realworldpixel/home-assistant-keypad/pcb/keypad.kicad_pcb

## KiCad design pcb/keypad.kicad_pcb (2026-10-27)

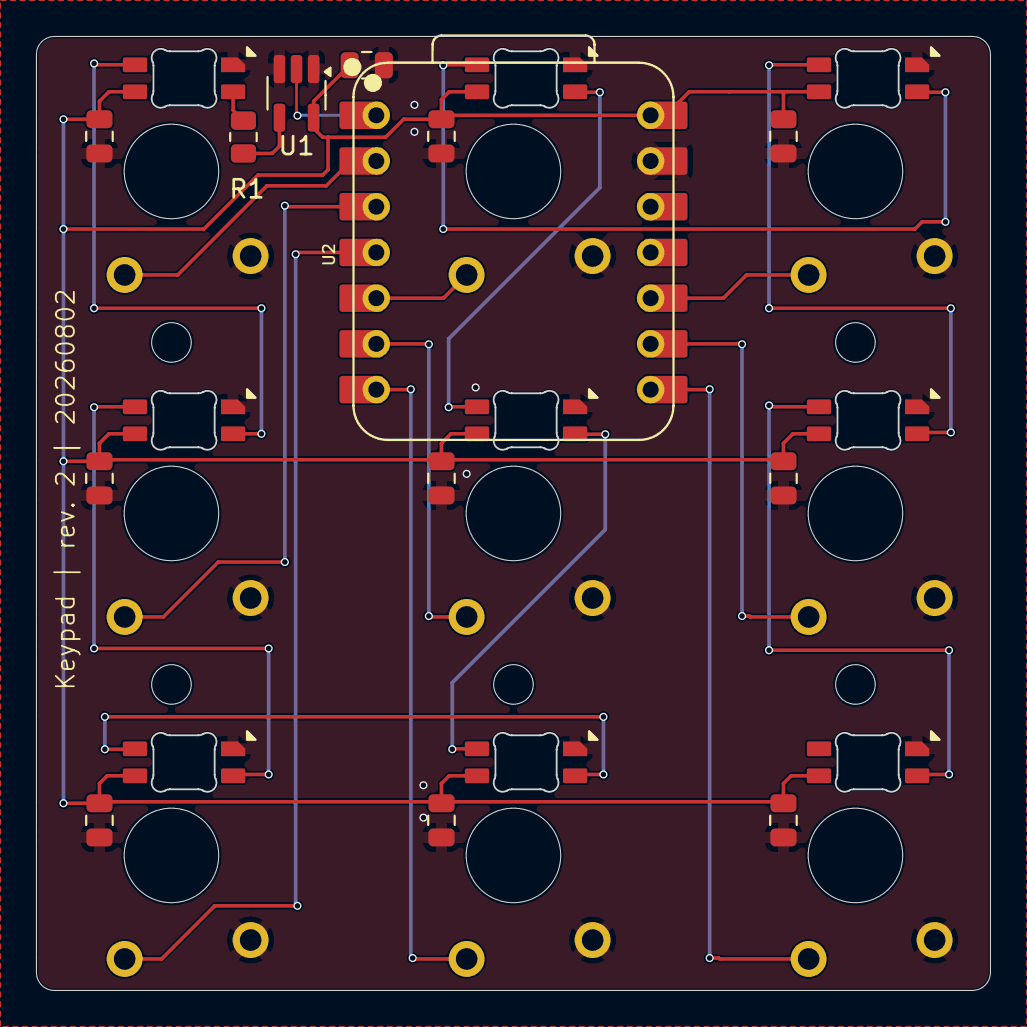
[picture p1: board keypad.kicad_pcb from above]

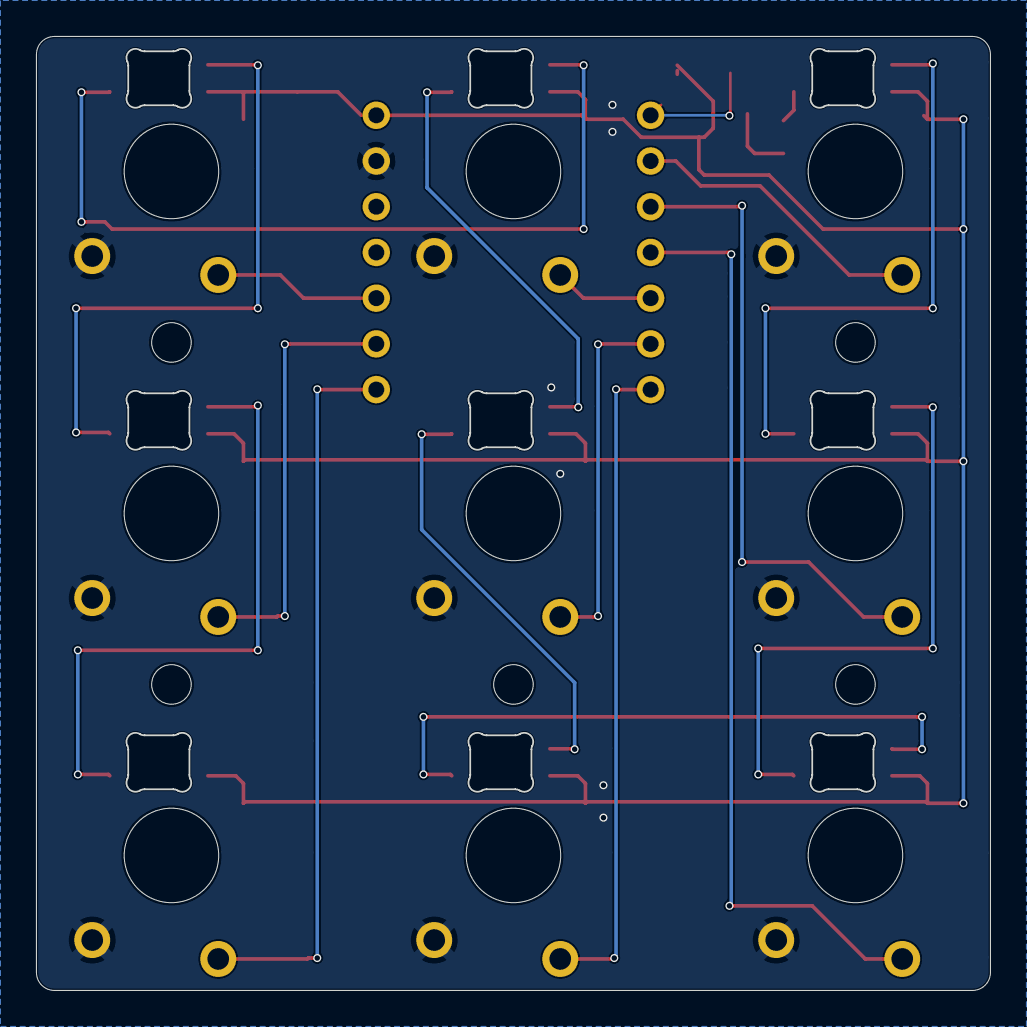
[picture p2: board keypad.kicad_pcb from below]

Board: 2 copper layers, 53.0 x 53.0 mm, 31 parts (9 on the bottom side), 22 nets.

Parts:
C1, C2, C3, C4, C5, C6, C7, C8, C9, C10: C; C_0805_2012Metric
LED1, LED2, LED3, LED4, LED5, LED6, LED7, LED8, LED9: KS33_SK6812MINI-E; LED_KS33_6028R
R1: 220; R_0805_2012Metric
SW1, SW2, SW3, SW4, SW5, SW6, SW7, SW8, SW9: KS33_SW_solder; SW_KS33_1u
U1: 74AHCT1G125; SOT-23-5_HandSoldering
U2: XIAO-ESP32-C6-DIP

Connections:
+5V: C1.1, C2.1, C3.1, C4.1, C5.1, C6.1, C7.1, C8.1, C9.1, C10.1, LED1.1 (VDD), LED2.1 (VDD), LED3.1 (VDD), LED4.1 (VDD), LED5.1 (VDD), LED6.1 (VDD), LED7.1 (VDD), LED8.1 (VDD), LED9.1 (VDD), U1.5, U2.14 (VBUS)
/LED_D3.3: U1.2, U2.1 (GPIO0_A0_D0)
/LED_D5.0: R1.1, U1.4
/SW1: SW1.2, U2.2 (GPIO1_A1_D1)
/SW2: SW2.2, U2.3 (GPIO2_A2_D2)
/SW3: SW3.2, U2.4 (GPIO21_D3)
/SW4: SW4.2, U2.5 (GPIO22_D4_SDA)
/SW5: SW5.2, U2.6 (GPIO23_D5_SCL)
/SW6: SW6.2, U2.7 (GPIO16_D6_TX)
/SW7: SW7.2, U2.8 (GPIO17_D7_RX)
/SW8: SW8.2, U2.9 (GPIO19_D8_SCK)
/SW9: SW9.2, U2.10 (GPIO20_D9_MISO)
/Switch Unit 1/DIN: LED1.3 (DIN), R1.2
/Switch Unit 1/DOUT: LED1.2 (DOUT), LED2.3 (DIN)
/Switch Unit 2/DOUT: LED2.2 (DOUT), LED3.3 (DIN)
/Switch Unit 3/DOUT: LED3.2 (DOUT), LED4.3 (DIN)
/Switch Unit 4/DOUT: LED4.2 (DOUT), LED5.3 (DIN)
/Switch Unit 5/DOUT: LED5.2 (DOUT), LED6.3 (DIN)
/Switch Unit 6/DOUT: LED6.2 (DOUT), LED7.3 (DIN)
/Switch Unit 7/DOUT: LED7.2 (DOUT), LED8.3 (DIN)
/Switch Unit 8/DOUT: LED8.2 (DOUT), LED9.3 (DIN)
GND: C1.2, C2.2, C3.2, C4.2, C5.2, C6.2, C7.2, C8.2, C9.2, C10.2, LED1.4 (VSS), LED2.4 (VSS), LED3.4 (VSS), LED4.4 (VSS), LED5.4 (VSS), LED6.4 (VSS), LED7.4 (VSS), LED8.4 (VSS), LED9.4 (VSS), SW1.1, SW2.1, SW3.1, SW4.1, SW5.1, SW6.1, SW7.1, SW8.1, SW9.1, U1.1, U1.3, U2.13 (GND)
