realworldpixel/home-assistant-keypad/(commit log)

2026-09-29 Add notes about SMD soldering.
2026-10-27 Swap U1 level shifter to SN74AHCT1G125DBVR (SOT-23-5)
    The SOT-353 part was hard to hand solder. Same 74AHCT1G125 pinout, so only
    the footprint changes. U1 shifts 0.1 mm right and its traces are rerouted;
    gerbers regenerated.
2026-10-27 Rearrange U1 corner: move U1 and R1, reroute 5V and SW1 traces
2026-10-27 Use hand-soldering SOT-23-5 footprint for U1
    Longer pads (1.56 x 0.65 mm) for easier hand soldering. Same position, pinout and routing; DRC unchanged.
2026-10-27 Regenerate gerbers for the hand-soldering U1 layout
    Exported with JLCPCB's KiCad settings: Protel extensions, X2 with netlist attributes, 4.6 mm, Excellon mm decimal with separate PTH/NPTH files.
